shehryarasiflone/Hardware-Piano-Tiles/(list of files, drawings)

Other design files:
PT Schematic.pdsprj
